Chronos-03/SmdGun/BOM.csv

Item # | Component | Supplier | Qty | Total (INR) | Total (USD) | Link
1 | Custom 3D-Printed Enclosure + Cradle | PrintLegion | 1 | 2500.0 | 26.88 | https://printinglegion.hackclub.com
2 | Custom 2-Layer PCB Manufacturing | Robu | 1 | 900.0 | 9.68 | https://robu.in/
3 | ESP32-S3-DevKitC-1-N8R8 | Robu | 1 | 1839.0 | 19.77 | https://robu.in/product/espressif-esp32-s3-devkitc-1-n8r8-development-board/
4 | 2.4" SPI TFT Touch Screen Module | MakerBazar | 1 | 679.0 | 7.3 | https://makerbazar.in/products/2-4-inch-spi-interface-240-320-tft-display-module?variant=44937178022128
5 | MAX6675 Thermocouple Module | MakerBazar | 1 | 309.0 | 3.32 | https://makerbazar.in/products/max6675-thermocouple-sensor-module
6 | LM2596 DC-DC Buck Step-Down Module | MakerBazar | 1 | 79.0 | 0.85 | https://makerbazar.in/products/lm2596-dc-dc-converter-step-down-module?variant=48251191918832
7 | Quick 858D Replacement Handle (8-wire) | TonyVision | 1 | 649.0 | 6.98 | https://www.tonyvision.in/product/30533442/Quick-858-Handle-For-858-SMD-Rework-Station--8-Wire-
8 | GX16-8 Aviation Socket (Panel Mount) | Probots | 1 | 160.0 | 1.72 | https://probots.co.in/8-pin-gx16-male-to-female-aviation-plug.html
9 | 24V 3A Metal Enclosed SMPS | ElecComp | 1 | 500.0 | 5.38 | https://www.electronicscomp.com/24v-3amp-smps-dc-metal-power-supply-nwp-india
10 | KW11-3Z Roller Lever Micro Switch | MakerBazar | 1 | 20.0 | 0.22 | https://makerbazar.in/products/automation-direct-limit-switch?variant=46931163742448
11 | IEC320 C14 AC Mains Socket + Rocker | Probots | 1 | 210.0 | 2.26 | https://probots.co.in/3-pin-iec320-c14-ac-power-socket-with-fuse-red-rocker-switch-panel-mount-connector.html
12 | Finned Aluminum Heatsink Kit | MakerBazar | 3 | 87.0 | 0.94 | https://makerbazar.in/products/3pcs-aluminum-heatsink-with-thermal-tape-for-raspberry-pi-4-model-b-black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
13 | KF301 2-Pin 5.08mm Screw Terminal | Robu | 2 | 20.0 | 0.22 | https://robu.in/product/kf301-2-pin-5-08mm-pitch-plug-in-screw-terminal-block-connector-pack-of-5/
14 | 240V AC Power Cord 3-Pin to IEC C-13 | MakerBazar | 1 | 159.0 | 1.71 | https://makerbazar.in/products/240v-ac-power-cord-3-pin-to-iec-c-13-female-cable?variant=44609024262384
15 | 20AWG Ultra Flexible Silicone Wire (Green) | Robu | 1 | 50.0 | 0.54 | https://robu.in/product/high-quality-ultra-flexible-20awg-silicone-wire-1000m-green/
16 | BTA16-600B TRIAC (Pack of 5) | Amazon | 1 | 169.0 | 1.82 | https://www.amazon.in/pics-BTA16-600B-TRIAC-Volts/dp/B0C9VVTZTV/
17 | MOC3041M Zero-Cross Optoisolator | Robu | 1 | 50.0 | 0.54 | https://robu.in/product/moc3041m-ic-zero-cross-optoisolator-triac-driver-ic/
18 | IRLZ44N Logic-Level N-Channel MOSFET | Robu | 1 | 44.0 | 0.47 | https://robu.in/product/irlz44n/
19 | 1N4007 1W Rectifier Diode | Robu | 5 | 15.0 | 0.16 | https://robu.in/product/1n4007-1w-diode-pack-of-30/
20 | Hongyan EC11 Rotary Encoders | Robu | 2 | 116.0 | 1.25 | https://robu.in/product/hongyan-ec11h-7ce20p1zy20-rotary-encoder-with-push-button-switch-vertical-plug-in-5-pin/
21 | Loose M3 Screws, Nuts & 1m Heat Shrink | Local Hardware Store | 1 | 50.0 | 0.54
22 | 330Ω 1/4W 1206 SMD Resistor | Robu | 1 | 15.0 | 0.16 | https://robu.in/product/330-ohm-1-4w-1206-surface-mount-chip-resistor-pack-of-100/
23 | 360Ω 0805 SMD Resistor (Yageo) | Robu | 1 | 15.0 | 0.16 | https://robu.in/product/rc0805fr-07360rl-yageo-360-ohms-%c2%b11-0-125w-1-8w-chip-resistor-0805-2012-metric-moisture-resistant-thick-film/
24 | 100Ω 1/4W 1206 SMD Resistor | Robu | 1 | 15.0 | 0.16 | https://robu.in/product/100-ohm-chip-resistor-1-4w-1206-surface-mount-pack-of-100/
25 | 10kΩ 0805 SMD Resistor | Amazon | 1 | 99.0 | 1.06 | https://www.amazon.in/Electronic-Spices-Power-Thick-Resistor/dp/B0BFD96R76/
26 | 100Ω 2W Carbon Film Resistor | Robu | 1 | 2.45 | 0.03 | https://robu.in/product/100-ohms-2w-carbon-film-resistor-pack-of-50/
27 | 100nF 400V DIP Polyester Film Cap | Robu | 1 | 6.0 | 0.06 | https://robu.in/product/100nf-400v-dip-polyester-film-capacitor-pitch10mm/
28 | 100nF 0805 SMD Ceramic Capacitor | Robu | 3 | 2.37 | 0.03 | https://robu.in/product/100nf-0805-surface-mount-multilayer-ceramic-capacitor-pack-of-40/
29 | 100µF 35V SMD Tantalum Capacitor | Robu | 1 | 57.0 | 0.61 | https://robu.in/product/100uf-35v-10-d-case-chip-tantalum-capacitorsmd-avx/
30 | DHRUV-PRO 120X120X38mm 24V Cooling Fan | Amazon | 1 | 579.0 | 6.23 | https://www.amazon.in/DHRUV-PRO-120X120X38mm-Cooling-120x120x38-MM-2800-RPM/dp/B0BTMC17SK/
 | FINAL GRAND TOTAL |  |  | 9395.82 | 101.05
