Chronos-03/SmdGun/CAD/DESIGN /final.step

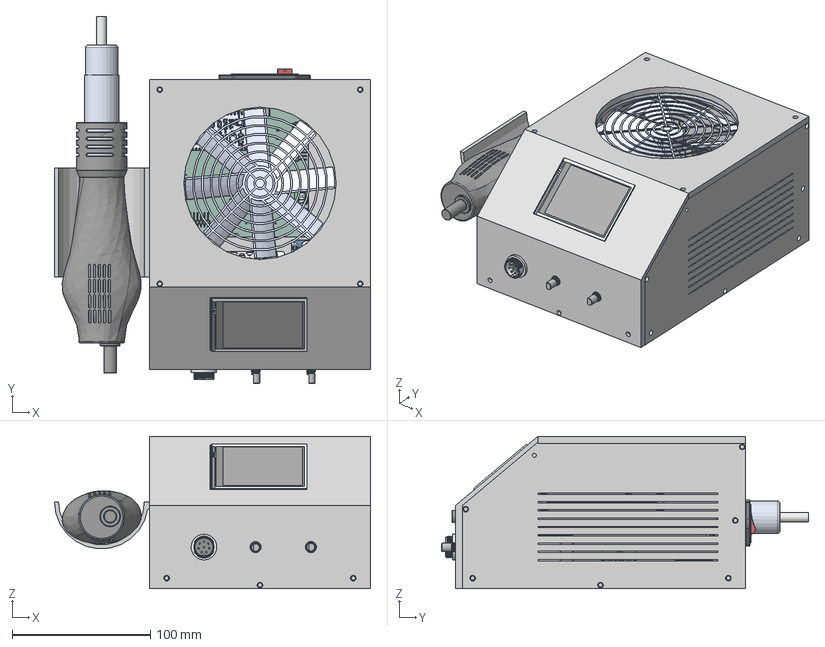
[picture p12: CAD file, 2026-11-11]
CAD/DESIGN /final.step
228.7 x 265.5 x 110.0 mm
