Chronos-03/SmdGun/CAD/PRODUCTION/sidepanel(right).step

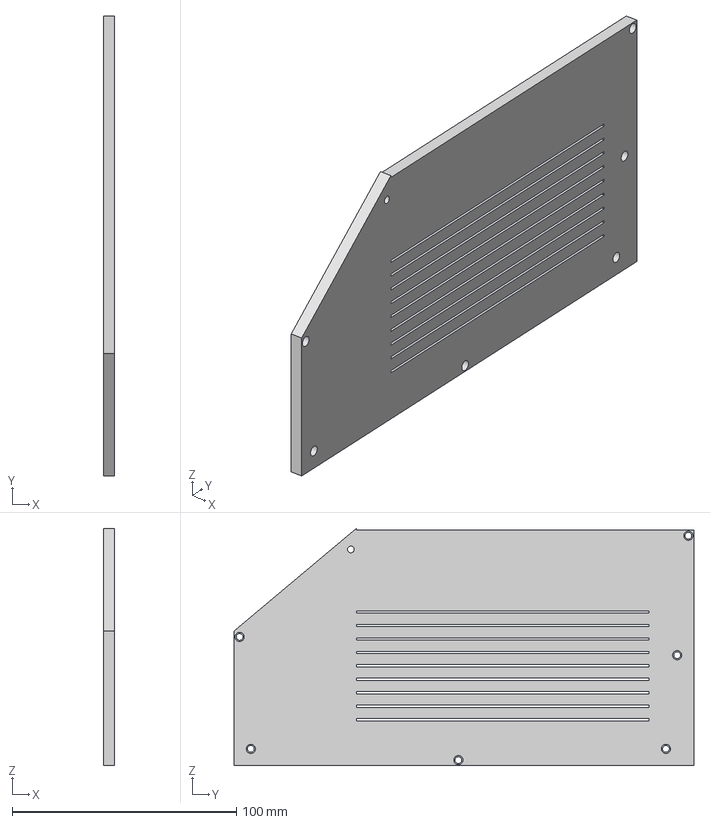
[picture p13: CAD file, 2026-11-11]
CAD/PRODUCTION/sidepanel(right).step
5.00 x 205.0 x 105.8 mm
