Chronos-03/SmdGun/CAD/PRODUCTION/holderlock1.step

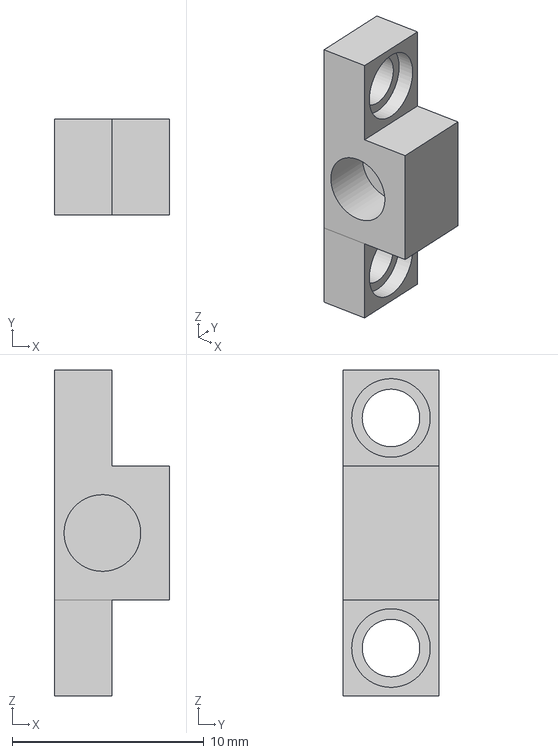
[picture p14: CAD file, 2026-11-11]
CAD/PRODUCTION/holderlock1.step
6.00 x 5.00 x 17.0 mm
