Chronos-03/SmdGun/CAD/PRODUCTION/frontpanel.step

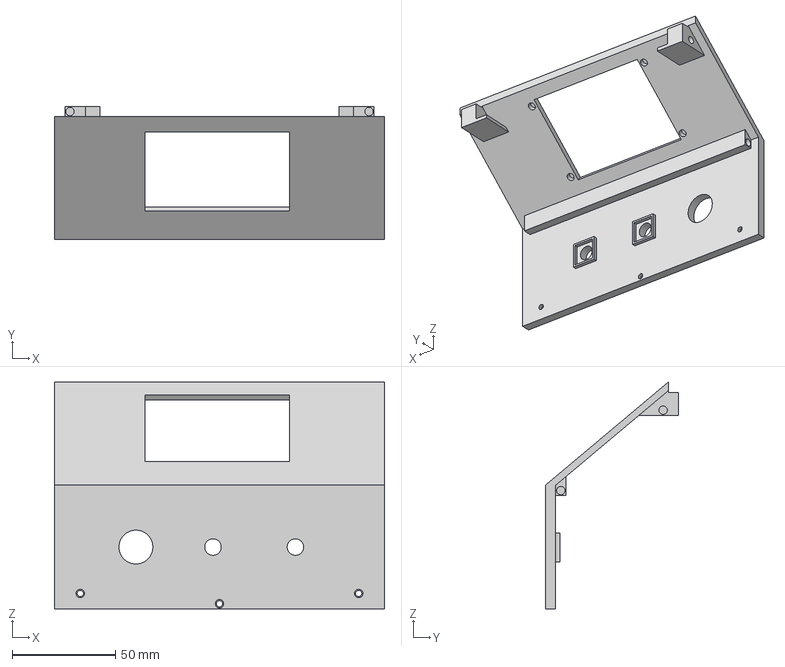
[picture p15: CAD file, 2026-11-11]
CAD/PRODUCTION/frontpanel.step
160.0 x 64.6 x 110.0 mm
