Chronos-03/SmdGun/CAD/PRODUCTION/gunholder.step

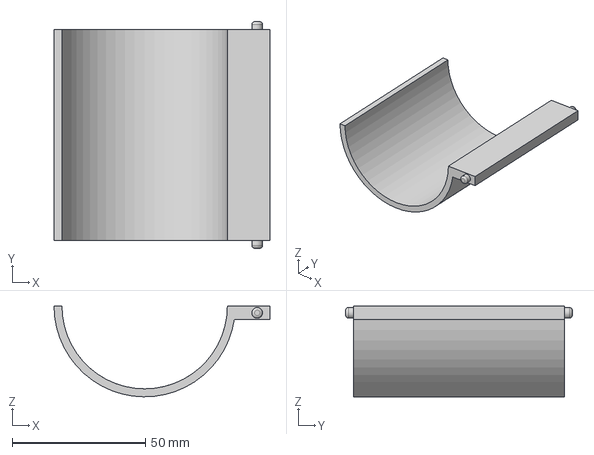
[picture p16: CAD file, 2026-11-11]
CAD/PRODUCTION/gunholder.step
81.0 x 85.0 x 34.0 mm
