Chronos-03/SmdGun/CAD/PRODUCTION/toppanel.step

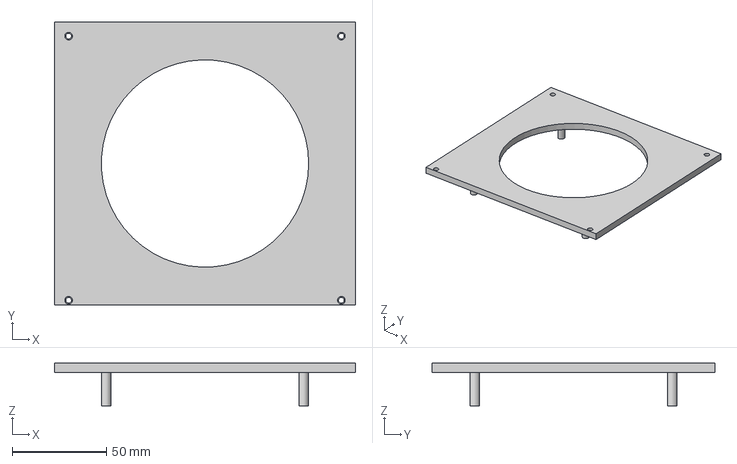
[picture p17: CAD file, 2026-11-11]
CAD/PRODUCTION/toppanel.step
160.0 x 150.4 x 22.8 mm
