Chronos-03/SmdGun/CAD/PRODUCTION/bottom.step

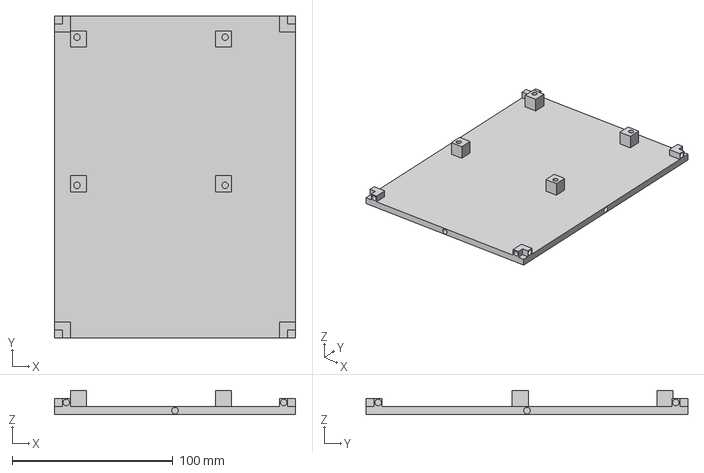
[picture p18: CAD file, 2026-11-11]
CAD/PRODUCTION/bottom.step
150.0 x 200.0 x 15.0 mm
