Chronos-03/SmdGun/CAD/PRODUCTION/backpanel.step

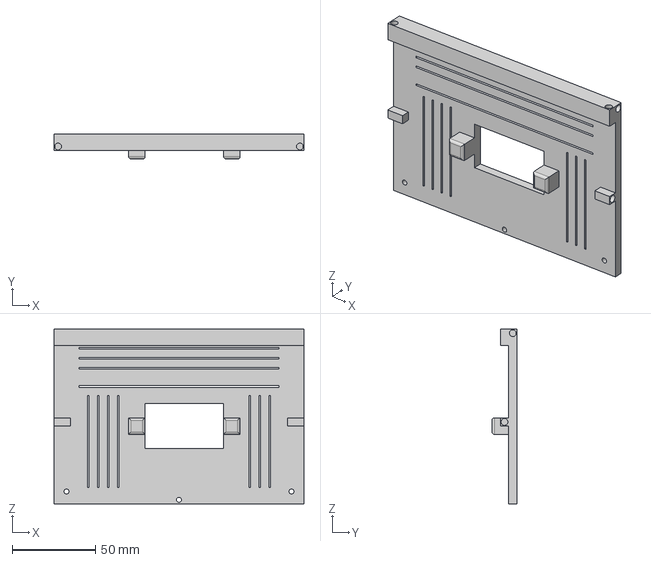
[picture p19: CAD file, 2026-11-11]
CAD/PRODUCTION/backpanel.step
150.0 x 15.0 x 105.0 mm
