Chronos-03/SmdGun/CAD/PRODUCTION/sidepanel(left).step

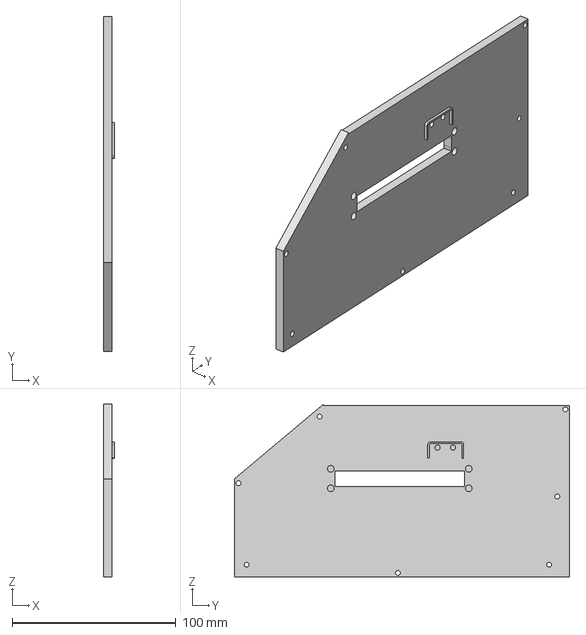
[picture p20: CAD file, 2026-11-11]
CAD/PRODUCTION/sidepanel(left).step
6.50 x 205.0 x 105.8 mm
