Chronos-03/SmdGun/(list of files, cad)

Other CAD files:
CAD/PRODUCTION/holderlock2.step
CAD/DESIGN /FINAL.f3z
CAD/DESIGN /final.stl
