Chronos-03/SmdGun/PCB/SMD.kicad_pcb

## KiCad design PCB/SMD.kicad_pcb (2026-11-12)

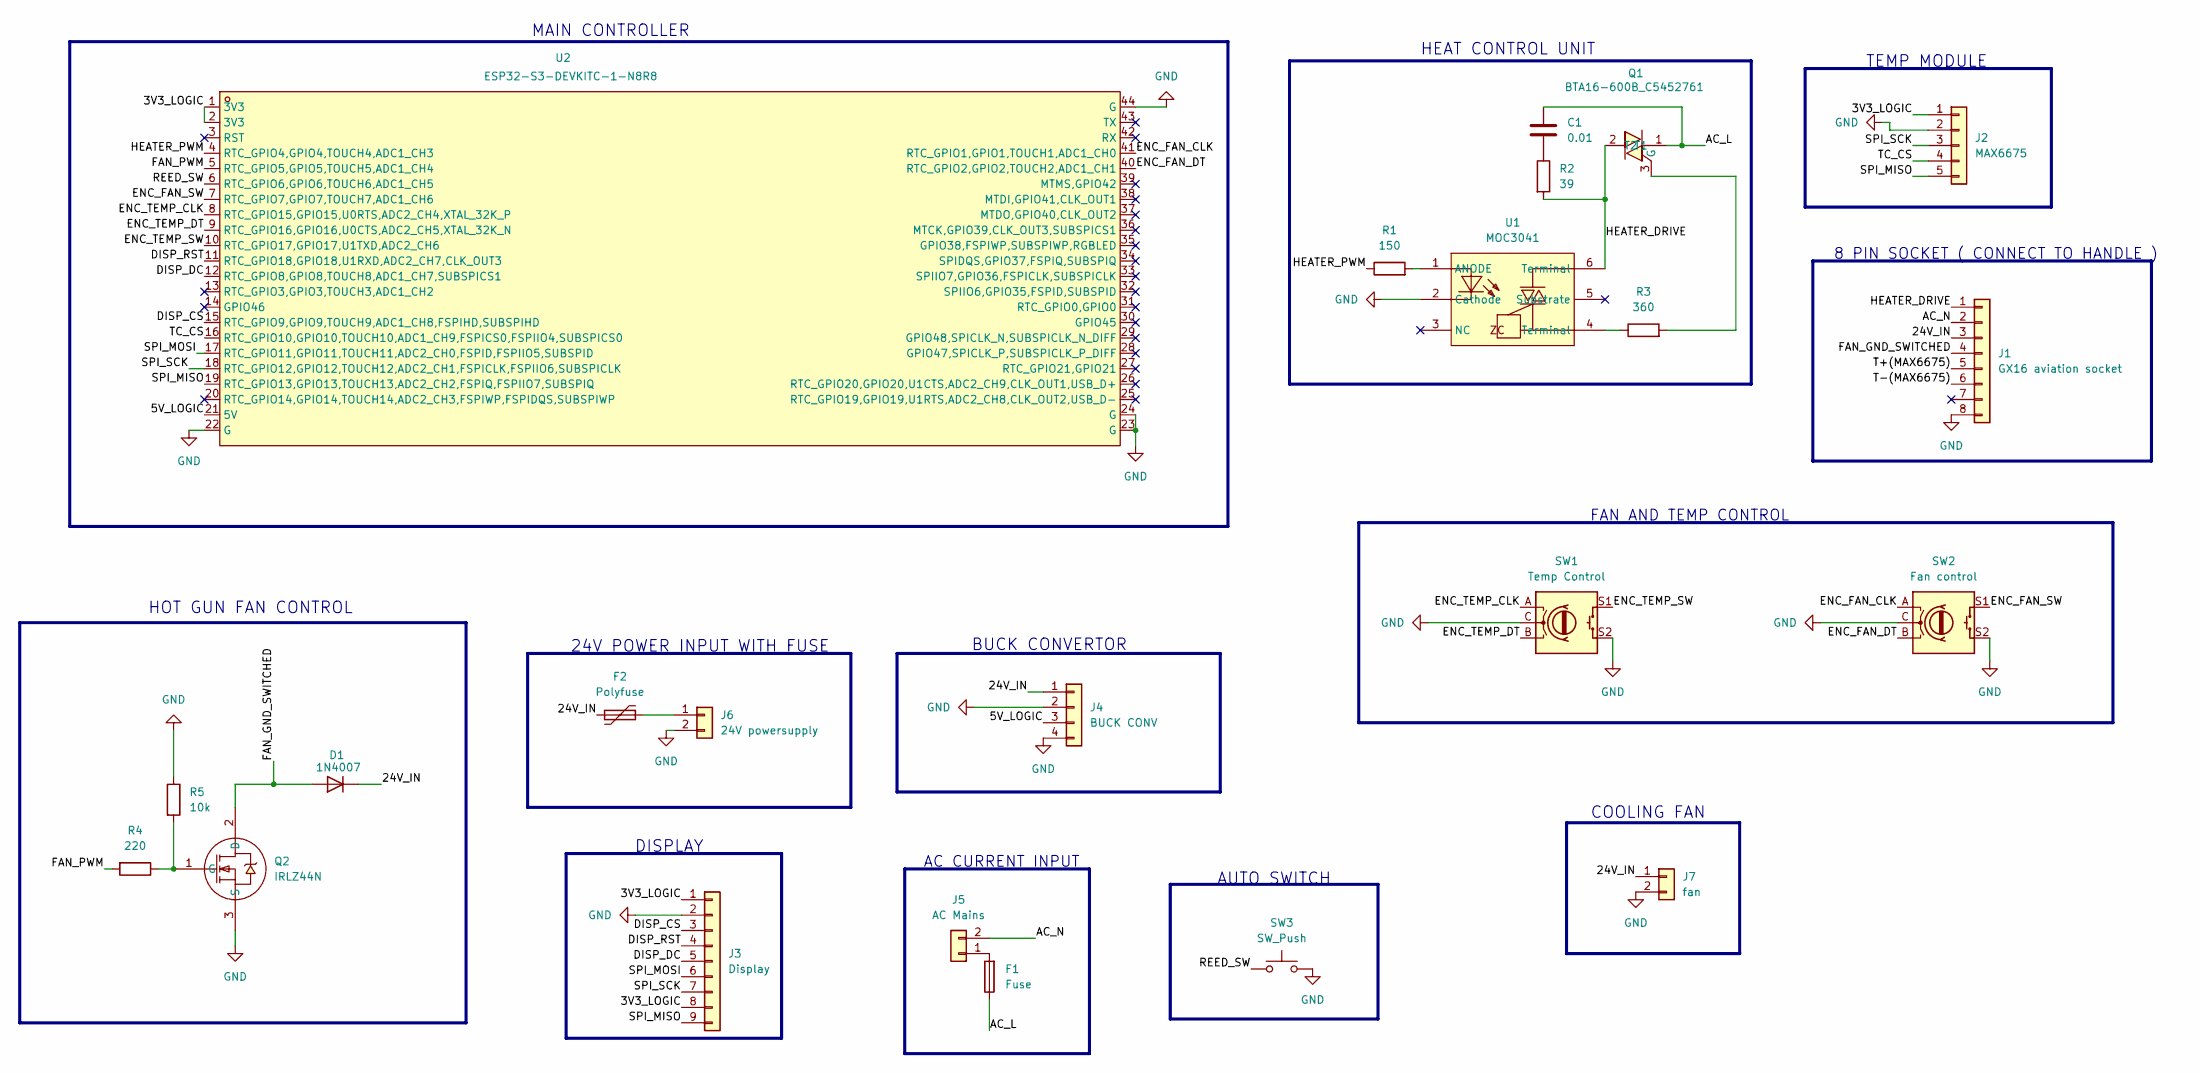
[picture p21: schematic SMD.kicad_sch]

Parts:
C1: 0.01; C_Rect_L18.0mm_W5.0mm_P15.00mm_FKS3_FKP3
D1: 1N4007; D_DO-41_SOD81_P10.16mm_Horizontal
F1: Fuse; Fuseholder_Cylinder-5x20mm_Schurter_0031_8201_Horizontal_Op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
F2: Polyfuse; Fuse_Bourns_MF-RHT200
J1: GX16 aviation socket; PinHeader_1x08_P2.54mm_Horizontal
J2: MAX6675; PinHeader_1x05_P2.54mm_Horizontal
J3: Display; PinHeader_1x09_P2.54mm_Horizontal
J4: BUCK CONV; PinHeader_1x04_P2.54mm_Horizontal
J5: AC Mains; TerminalBlock_Phoenix_MKDS-1,5-2-5.08_1x02_P5.08mm_Horizont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
J6: 24V powersupply; TerminalBlock_Phoenix_MKDS-1,5-2-5.08_1x02_P5.08mm_Horizont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
J7: fan; PinHeader_1x02_P2.54mm_Vertical
Q1: BTA16-600B_C5452761; TO-220-3_L10.0-W4.5-P2.54-L_1; MPN BTA16-600B; LCSC Part C5452761
Q2: IRLZ44N; TO-220-3_L10.2-W4.5-P2.54-L; MPN IRLZ44N(UMW); LCSC Part C42370423
R1: 150; R_0805_2012Metric
R2: 39; R_Axial_DIN0414_L11.9mm_D4.5mm_P15.24mm_Horizontal
R3: 360; R_0805_2012Metric
R4: 220; R_0805_2012Metric
R5: 10k; R_0805_2012Metric
SW1: Temp Control; RotaryEncoder_Alps_EC11E-Switch_Vertical_H20mm
SW2: Fan control; RotaryEncoder_Alps_EC11E-Switch_Vertical_H20mm
SW3: SW_Push; PinHeader_1x02_P2.54mm_Vertical
U1: MOC3041; DIP-6_L7.3-W6.5-P2.54-LS7.6-BL; MPN MOC3041; LCSC Part C6177963
U2: ESP32-S3-DEVKITC-1-N8R8; CONN-TH_ESP32-S3-DEVKITC-1U-N8; MPN ESP32-S3-DEVKITC-1-N8R8; LCSC Part C20541519

Connections:
/3V3_LOGIC: J2.1, J3.1, J3.8, U2.1 (3V3), U2.2 (3V3)
/5V_LOGIC: J4.3, U2.21 (5V)
/24V_IN: D1.1 (K), F2.2, J1.3, J4.1, J7.1
/AC_L: C1.1, F1.1, Q1.1 (T1)
/AC_N: J1.2, J5.2
/DISP_CS: J3.3, U2.15 (RTC_GPIO9,GPIO9,TOUCH9,ADC1_CH8,FSPIHD,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)
/DISP_DC: J3.5, U2.12 (RTC_GPIO8,GPIO8,TOUCH8,ADC1_CH7,SUBSPIC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)
/DISP_RST: J3.4, U2.11 (RTC_GPIO18,GPIO18,U1RXD,ADC2_CH7,CLK_OU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)
/ENC_FAN_CLK: SW2.A, U2.41 (RTC_GPIO1,GPIO1,TOUCH1,ADC1_CH0)
/ENC_FAN_DT: SW2.B, U2.40 (RTC_GPIO2,GPIO2,TOUCH2,ADC1_CH1)
/ENC_FAN_SW: SW2.S1, U2.7 (RTC_GPIO7,GPIO7,TOUCH7,ADC1_CH6)
/ENC_TEMP_CLK: SW1.A, U2.8 (RTC_GPIO15,GPIO15,U0RTS,ADC2_CH4,XTAL_3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)
/ENC_TEMP_DT: SW1.B, U2.9 (RTC_GPIO16,GPIO16,U0CTS,ADC2_CH5,XTAL_3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)
/ENC_TEMP_SW: SW1.S1, U2.10 (RTC_GPIO17,GPIO17,U1TXD,ADC2_CH6)
/FAN_GND_SWITCHED: D1.2 (A), J1.4, Q2.2 (D)
/FAN_PWM: R4.2, U2.5 (RTC_GPIO5,GPIO5,TOUCH5,ADC1_CH4)
/HEATER_DRIVE: J1.1, Q1.2 (T2), R2.2, U1.6 (Terminal)
/HEATER_PWM: R1.1, U2.4 (RTC_GPIO4,GPIO4,TOUCH4,ADC1_CH3)
/REED_SW: SW3.1, U2.6 (RTC_GPIO6,GPIO6,TOUCH6,ADC1_CH5)
/SPI_MISO: J2.5, J3.9, U2.19 (RTC_GPIO13,GPIO13,TOUCH13,ADC2_CH2,FSPI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)
/SPI_MOSI: J3.6, U2.17 (RTC_GPIO11,GPIO11,TOUCH11,ADC2_CH0,FSPI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)
/SPI_SCK: J2.3, J3.7, U2.18 (RTC_GPIO12,GPIO12,TOUCH12,ADC2_CH1,FSPI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)
/T+(MAX6675): J1.5
/T-(MAX6675): J1.6
/TC_CS: J2.4, U2.16 (RTC_GPIO10,GPIO10,TOUCH10,ADC1_CH9,FSPI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)
GND: J1.8, J2.2, J3.2, J4.2, J4.4, J6.2, J7.2, Q2.3 (S), R5.1, SW1.C, SW1.S2, SW2.C, SW2.S2, SW3.2, U1.2 (Cathode), U2.22 (G), U2.23 (G), U2.24 (G), U2.44 (G)
unnamed: C1.2, R2.1
unnamed: F1.2, J5.1
unnamed: F2.1, J6.1
unnamed: Q1.3 (G), R3.2
unnamed: Q2.1 (G), R4.1, R5.2
unnamed: R3.1, U1.4 (Terminal)
unnamed: R1.2, U1.1 (ANODE)

Notes on the sheet:
HOT GUN FAN CONTROL
DISPLAY
MAIN CONTROLLER
AUTO SWITCH
BUCK CONVERTOR
AC CURRENT INPUT
TEMP MODULE
24V POWER INPUT WITH FUSE
8 PIN SOCKET ( CONNECT TO HANDLE )
FAN AND TEMP CONTROL
HEAT CONTROL UNIT
COOLING FAN

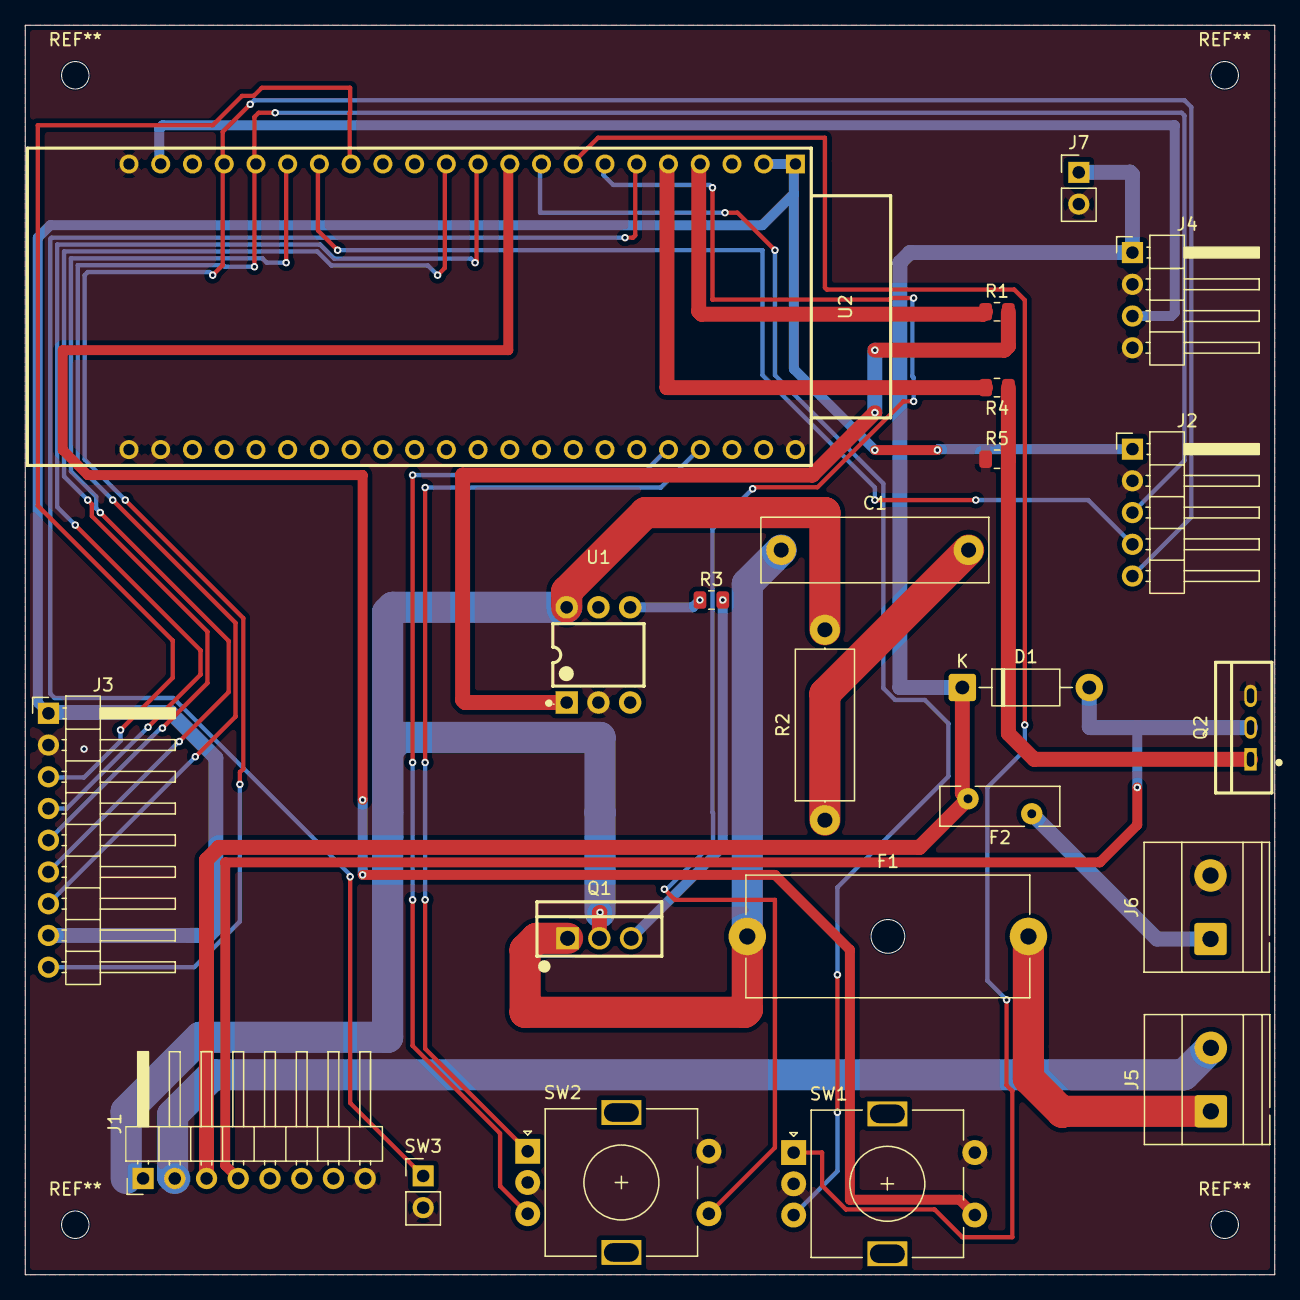
[picture p22: board SMD.kicad_pcb from above]

Board: 2 copper layers, 100.0 x 100.0 mm, 23 parts (0 on the bottom side), 31 nets.
