Chronos-03/SmdGun/(commit log)

2026-11-11 all changes
    [FINAL.f3z, SMD.kicad_pcb, SMD.kicad_sch, backpanel.step, bottom.step, final.step, final.stl, frontpanel.step]
2026-11-11 final push
    [BOM.csv]
